nicotakuya/piga-player/piga_player_schematics.png

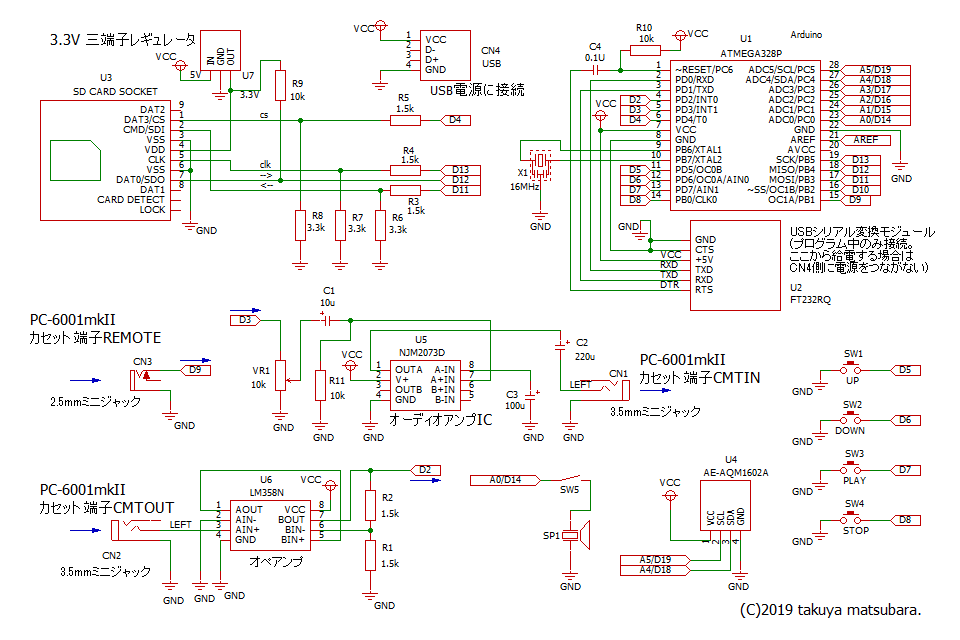
piga_player_schematics.png
