nicotakuya/piga-player/piga_waveform.png

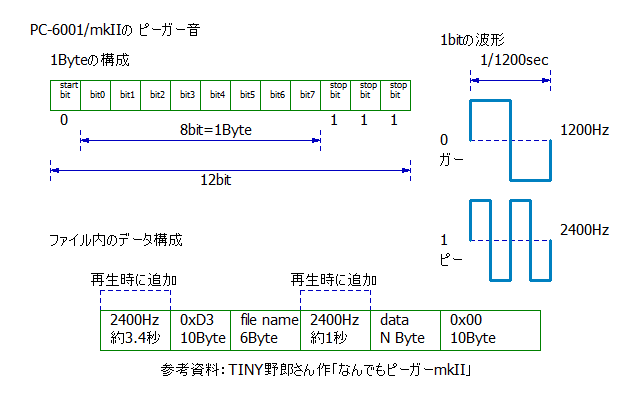
piga_waveform.png
